petrohi/color_terminal/hardware/ascii_terminal_kicad.kicad_pcb

## KiCad design hardware/ascii_terminal_kicad.kicad_pcb (2020-11-22)

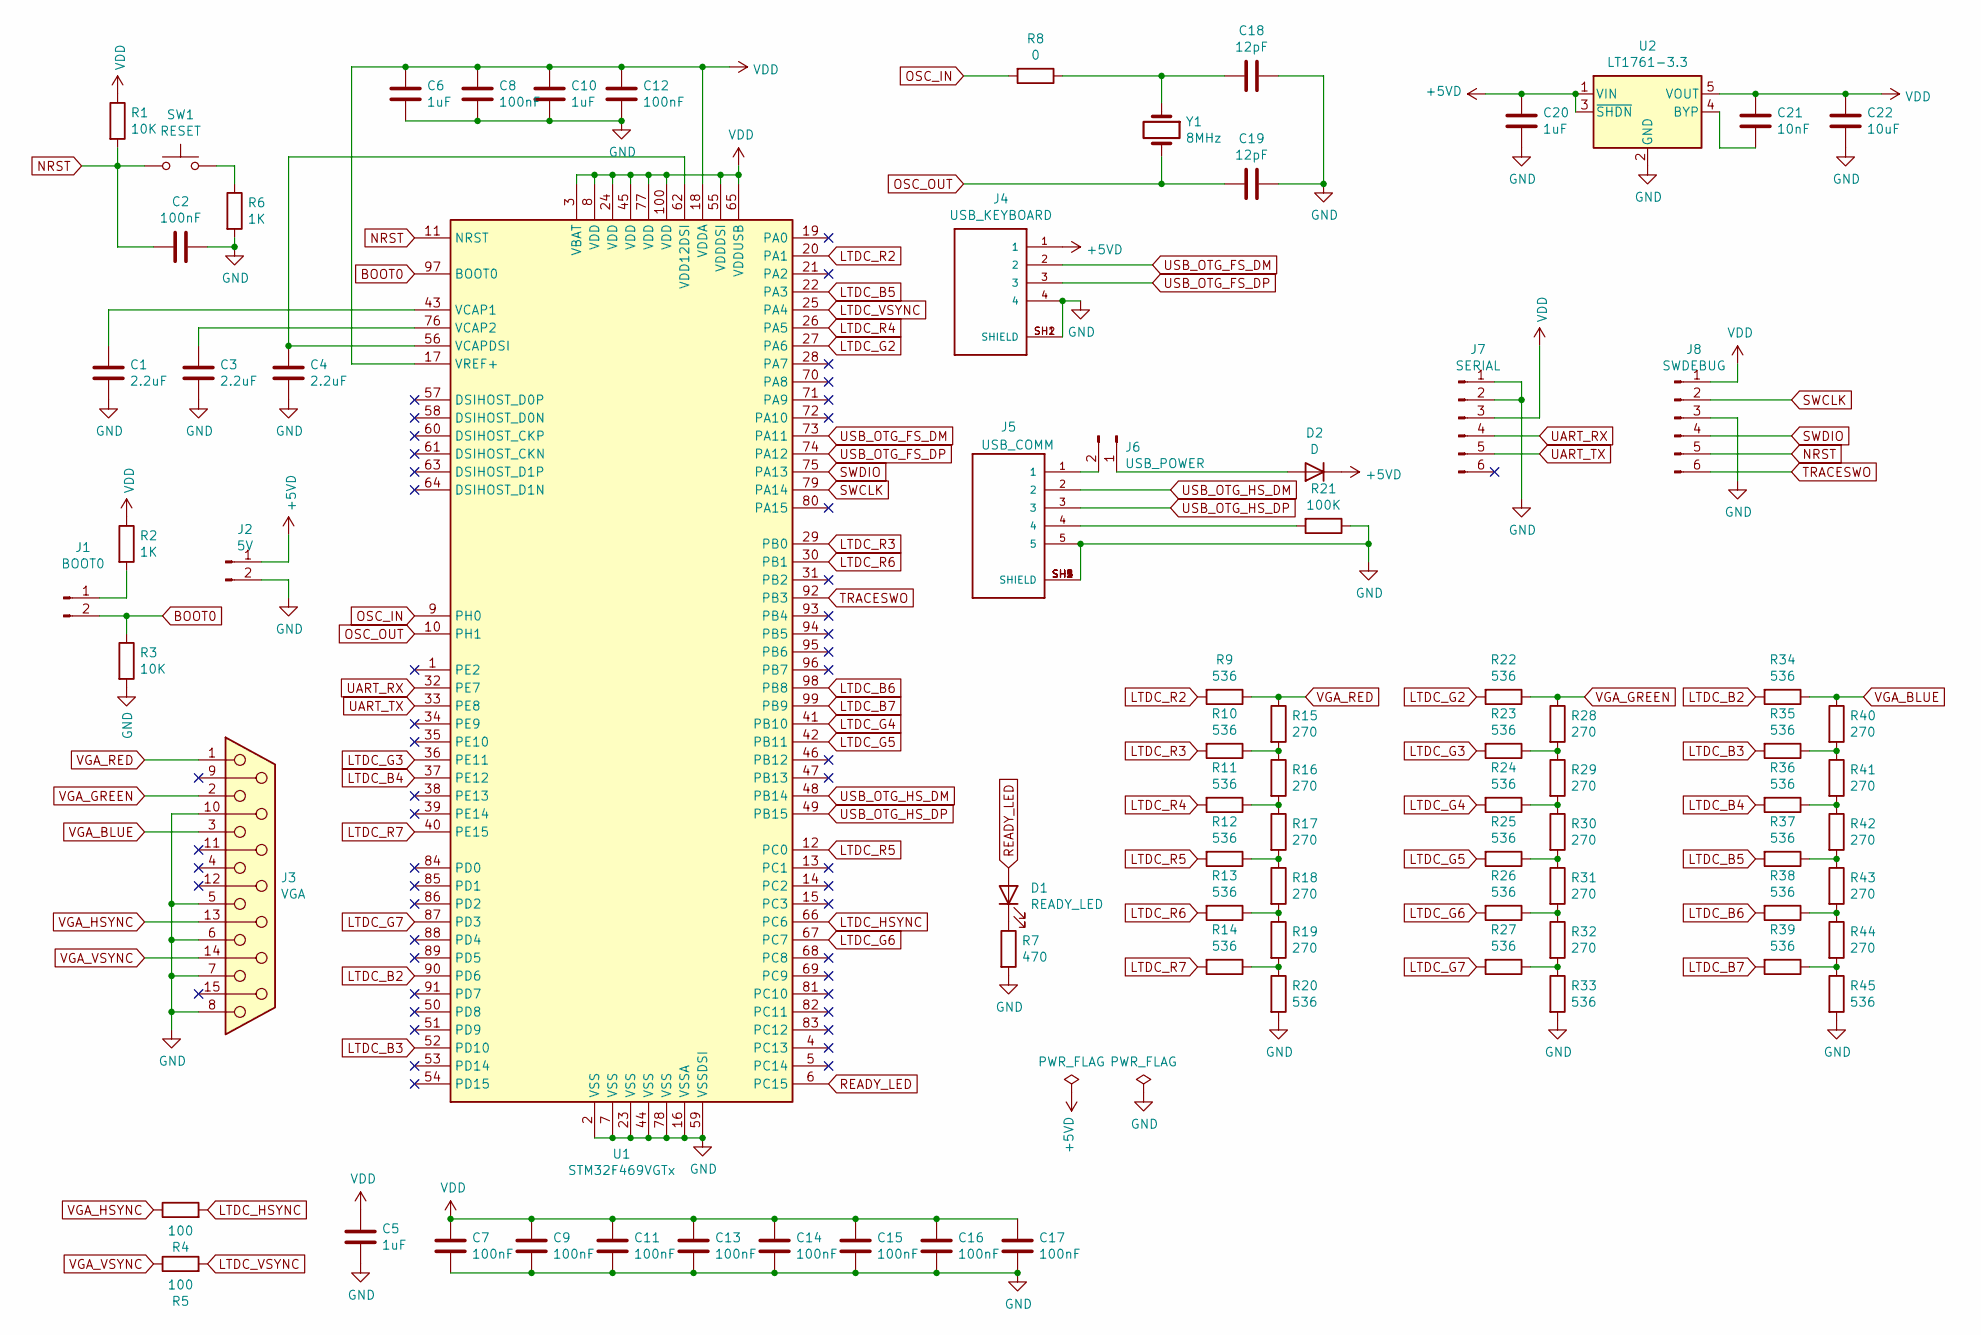
[picture p1: schematic ascii_terminal_kicad.sch]

Parts:
C1, C3, C4: 2.2uF; C_0805_2012Metric
C2, C7, C8, C9, C11, C12, C13, C14, C15, C16, C17: 100nF; C_0805_2012Metric
C5, C6, C10, C20: 1uF; C_0805_2012Metric
C18, C19: 12pF; C_0805_2012Metric
C21: 10nF; C_0805_2012Metric
C22: 10uF; C_0805_2012Metric
D1: READY_LED; LED_0805_2012Metric
D2: D; D_1206_3216Metric
J1: BOOT0; PinHeader_1x02_P2.54mm_Vertical
J2: 5V; PinHeader_1x02_P2.54mm_Vertical
J3: VGA; AMPHENOL_L77HDE15SD1CH4F
J4: USB_KEYBOARD; CUI_UJ2-AH-4-TH
J5: USB_COMM; CUI_UJ2-MIBH2-4-SMT
J6: USB_POWER; PinHeader_1x02_P2.54mm_Vertical
J7: SERIAL; PinHeader_1x06_P2.54mm_Vertical
J8: SWDEBUG; PinHeader_1x06_P2.54mm_Vertical
R1, R3: 10K; R_0805_2012Metric
R2, R6: 1K; R_0805_2012Metric
R4, R5: 100; R_0805_2012Metric
R7: 470; R_0805_2012Metric
R8: 0; R_0805_2012Metric
R9, R10, R11, R12, R13, R14, R20, R22, R23, R24, R25, R26, R27, R33, R34, R35, R36, R37, R38, R39, R45: 536; R_0805_2012Metric
R15, R16, R17, R18, R19, R28, R29, R30, R31, R32, R40, R41, R42, R43, R44: 270; R_0805_2012Metric
R21: 100K; R_0805_2012Metric
SW1: RESET; SW_SPST_FSMSM
U1: STM32F469VGTx; LQFP-100_14x14mm_P0.5mm
U2: LT1761-3.3; TSOT-23-5
Y1: 8MHz; Crystal_SMD_5032-2Pin_5.0x3.2mm

Connections:
+5VD: C20.1, D2.1 (K), J2.1, J4.1, U2.1 (VIN), U2.3 (~SHDN)
BOOT0: J1.2, R3.1, U1.97 (BOOT0)
GND: C1.2, C2.1, C3.2, C4.2, C5.2, C6.2, C7.2, C8.2, C9.2, C10.2, C11.2, C12.2, C13.2, C14.2, C15.2, C16.2, C17.2, C18.1, C19.1, C20.2, C22.2, J2.2, J3.5, J3.6, J3.7, J3.8, J3.10, J4.4, J4.SH1 (SHIELD), J4.SH2 (SHIELD), J5.5, J5.SH1 (SHIELD), J5.SH2 (SHIELD), J5.SH3 (SHIELD), J5.SH4 (SHIELD), J5.SH5 (SHIELD), J7.1, J7.2, J8.3, R3.2, R6.2, R7.2, R20.2, R21.1, R33.2, R45.2, U1.2 (VSS), U1.7 (VSS), U1.16 (VSSA), U1.23 (VSS), U1.44 (VSS), U1.59 (VSSDSI), U1.78 (VSS), U2.2 (GND)
LTDC_B2: R34.2, U1.90 (PD6)
LTDC_B3: R35.2, U1.52 (PD10)
LTDC_B4: R36.2, U1.37 (PE12)
LTDC_B5: R37.2, U1.22 (PA3)
LTDC_B6: R38.2, U1.98 (PB8)
LTDC_B7: R39.2, U1.99 (PB9)
LTDC_G2: R22.2, U1.27 (PA6)
LTDC_G3: R23.2, U1.36 (PE11)
LTDC_G4: R24.2, U1.41 (PB10)
LTDC_G5: R25.2, U1.42 (PB11)
LTDC_G6: R26.2, U1.67 (PC7)
LTDC_G7: R27.2, U1.87 (PD3)
LTDC_HSYNC: R4.2, U1.66 (PC6)
LTDC_R2: R9.2, U1.20 (PA1)
LTDC_R3: R10.2, U1.29 (PB0)
LTDC_R4: R11.2, U1.26 (PA5)
LTDC_R5: R12.2, U1.12 (PC0)
LTDC_R6: R13.2, U1.30 (PB1)
LTDC_R7: R14.2, U1.40 (PE15)
LTDC_VSYNC: R5.2, U1.25 (PA4)
NRST: C2.2, J8.5, R1.2, SW1.1, U1.11 (NRST)
unnamed: C1.1, U1.43 (VCAP1)
unnamed: C3.1, U1.76 (VCAP2)
unnamed: C4.1, U1.56 (VCAPDSI), U1.62 (VDD12DSI)
unnamed: C18.2, R8.1, Y1.1
unnamed: C21.2, U2.4 (BYP)
unnamed: D1.1 (K), R7.1
unnamed: D2.2 (A), J6.1
unnamed: J1.1, R2.2
unnamed: J5.1, J6.2
unnamed: J5.4, R21.2
unnamed: R6.1, SW1.2
unnamed: R10.1, R15.2, R16.1
unnamed: R11.1, R16.2, R17.1
unnamed: R12.1, R17.2, R18.1
unnamed: R13.1, R18.2, R19.1
unnamed: R14.1, R19.2, R20.1
unnamed: R23.1, R28.2, R29.1
unnamed: R24.1, R29.2, R30.1
unnamed: R25.1, R30.2, R31.1
unnamed: R26.1, R31.2, R32.1
unnamed: R27.1, R32.2, R33.1
unnamed: R35.1, R40.2, R41.1
unnamed: R36.1, R41.2, R42.1
unnamed: R37.1, R42.2, R43.1
unnamed: R38.1, R43.2, R44.1
unnamed: R39.1, R44.2, R45.1
OSC_IN: R8.2, U1.9 (PH0)
OSC_OUT: C19.2, U1.10 (PH1), Y1.2
READY_LED: D1.2 (A), U1.6 (PC15)
SWCLK: J8.2, U1.79 (PA14)
SWDIO: J8.4, U1.75 (PA13)
TRACESWO: J8.6, U1.92 (PB3)
UART_RX: J7.4, U1.32 (PE7)
UART_TX: J7.5, U1.33 (PE8)
USB_OTG_FS_DM: J4.2, U1.73 (PA11)
USB_OTG_FS_DP: J4.3, U1.74 (PA12)
USB_OTG_HS_DM: J5.2, U1.48 (PB14)
USB_OTG_HS_DP: J5.3, U1.49 (PB15)
VDD: C5.1, C6.1, C7.1, C8.1, C9.1, C10.1, C11.1, C12.1, C13.1, C14.1, C15.1, C16.1, C17.1, C21.1, C22.1, J7.3, J8.1, R1.1, R2.1, U1.3 (VBAT), U1.8 (VDD), U1.17 (VREF+), U1.18 (VDDA), U1.24 (VDD), U1.45 (VDD), U1.55 (VDDDSI), U1.65 (VDDUSB), U1.77 (VDD), U1.100 (VDD), U2.5 (VOUT)
VGA_BLUE: J3.3, R34.1, R40.1
VGA_GREEN: J3.2, R22.1, R28.1
VGA_HSYNC: J3.13, R4.1
VGA_RED: J3.1, R9.1, R15.1
VGA_VSYNC: J3.14, R5.1

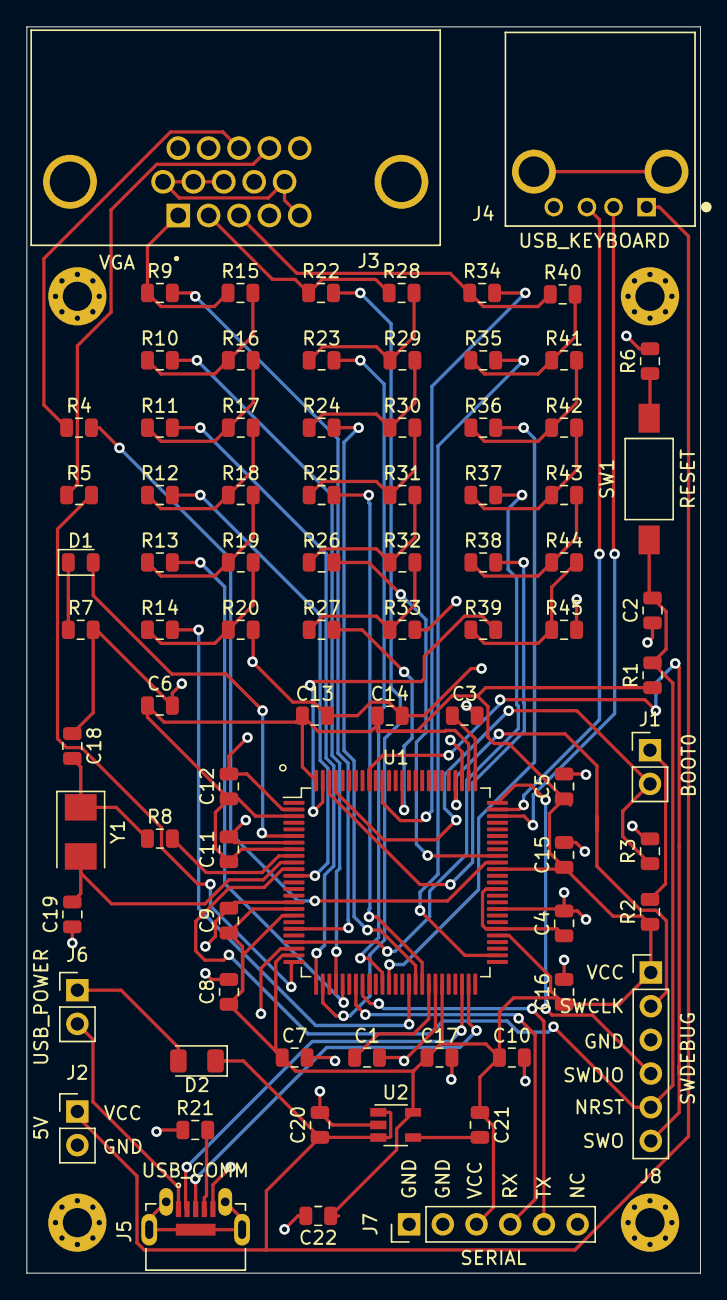
[picture p2: board ascii_terminal_kicad.kicad_pcb from above]

Board: 2 copper layers, 50.8 x 94.0 mm, 85 parts (0 on the bottom side), 68 nets.

Other parts of the board:
REF1, REF2, REF3, REF4: MountingHole_2.2mm_M2_Pad_Via
