petrohi/color_terminal/color_terminal.ioc

PC15/OSC32_OUT.GPIO_Label=READY_LED
Mcu.UserName=STM32F469VGTx
PB11.Signal=LTDC_G5
PB15.Signal=USB_OTG_HS_DP
PA12.Signal=USB_OTG_FS_DP
PC7.Signal=LTDC_G6
PH1/OSC_OUT.Signal=RCC_OSC_OUT
PE13.Signal=LTDC_DE
PB9.Signal=LTDC_B7
PB1.Signal=LTDC_R6
PA6.Signal=LTDC_G2
PE7.Signal=UART7_RX
PD6.Signal=LTDC_B2
PA3.Signal=LTDC_B5
PD3.Signal=LTDC_G7
PC6.Signal=LTDC_HSYNC
PC0.Signal=LTDC_R5
PD10.Signal=LTDC_B3
PE11.Signal=LTDC_G3
PA1.Signal=LTDC_R2
PB10.Signal=LTDC_G4
PB14.Signal=USB_OTG_HS_DM
PA5.Signal=LTDC_R4
PH0/OSC_IN.Signal=RCC_OSC_IN
PE14.Signal=LTDC_CLK
PE15.Signal=LTDC_R7
PE8.Signal=UART7_TX
PE12.Signal=LTDC_B4
PA4.Signal=LTDC_VSYNC
PA11.Signal=USB_OTG_FS_DM
PB8.Signal=LTDC_B6
PC15/OSC32_OUT.Signal=GPIO_Output
PB0.Signal=LTDC_R3
