petrohi/color_terminal/Core/Inc/terminal_internal.h

#pragma once

#include "terminal.h"

#define CHAR_XOFF '\x13'
#define CHAR_XON '\x11'

#define ROWS terminal->format.rows
#define COLS terminal->format.cols

void terminal_uart_init(struct terminal *terminal);

void terminal_uart_xon_off(struct terminal *terminal, enum xon_off xon_off);

void terminal_keyboard_init(struct terminal *terminal,
                            enum keyboard_layout keyboard_layout);

void terminal_keyboard_update_repeat_counter(struct terminal *terminal);

void terminal_screen_init(struct terminal *terminal);

int16_t get_terminal_screen_cursor_row(struct terminal *terminal);

int16_t get_terminal_screen_cursor_col(struct terminal *terminal);

void terminal_screen_update_cursor_counter(struct terminal *terminal);

void terminal_screen_update_blink_counter(struct terminal *terminal);

void terminal_screen_move_cursor_absolute(struct terminal *terminal,
                                          int16_t row, int16_t col);

void terminal_screen_move_cursor(struct terminal *terminal, int16_t rows,
                                 int16_t cols);

void terminal_screen_carriage_return(struct terminal *terminal);

void terminal_screen_scroll(struct terminal *terminal, enum scroll scroll,
                            size_t from_row, size_t rows);

void terminal_screen_clear_to_right(struct terminal *terminal);

void terminal_screen_clear_to_left(struct terminal *terminal);

void terminal_screen_clear_row(struct terminal *terminal);

void terminal_screen_clear_to_top(struct terminal *terminal);

void terminal_screen_clear_to_bottom(struct terminal *terminal);

void terminal_screen_clear_all(struct terminal *terminal);

void terminal_screen_index(struct terminal *terminal, int16_t rows);

void terminal_screen_reverse_index(struct terminal *terminal, int16_t rows);

void terminal_screen_put_codepoint(struct terminal *terminal,
                                   codepoint_t codepoint);

void terminal_screen_enable_cursor(struct terminal *terminal, bool enable);

void terminal_screen_save_visual_state(struct terminal *terminal);

void terminal_screen_restore_visual_state(struct terminal *terminal);

void terminal_screen_delete(struct terminal *terminal, size_t cols);

void terminal_screen_insert(struct terminal *terminal, size_t cols);

void terminal_screen_erase(struct terminal *terminal, size_t cols);

void terminal_screen_set_screen_mode(struct terminal *terminal, bool mode);

void terminal_screen_wrap_last_col(struct terminal *terminal);

void terminal_screen_cancel_wrap_last_col(struct terminal *terminal);

#ifdef TERMINAL_ALT_CELLS
void terminal_screen_use_alt_cells(struct terminal *terminal);

void terminal_screen_restore_default_cells(struct terminal *terminal);
#endif
