petrohi/color_terminal/(commit log)

2020-06-07 DMA for UART
2020-06-08 UART transmit
2020-06-08 Print current Mandelbrot window to UART
2020-06-11 Circular DMA mode for UART receive
2020-06-14 Receive from UART and draw characters
2020-06-20 Split terminal into UART, keyboard and screen modules
2020-06-21 Printf unexpected control sequence
2020-06-23 Default auto-wrap mode to reset
    [terminal_screen.c]
2020-06-23 Set UART to 38400 baud rate
2020-06-25 Insert/delete/erase characters. Absolute vertical/horizontal position.
2020-06-26 Insert/delete lines
2020-06-28 Tab stops. Printf control sequences.
2020-06-29 Fix transmit printf
2020-07-04 Back to font-problems. Handle UTF8 via receive tables.
    [main.c, screen.c, screen.h, terminal.h, terminal_uart.c]
2020-07-07 Use USART3. Flow control with XON/OFF.
2020-07-19 Circular buffering for UART transmit
2020-07-26 Yield to probe keyboard
2020-07-29 Probe keyboard when in config UI
2020-07-31 Config for flow control and inverted serial
    [main.c, terminal.c, terminal.h, terminal_config.h, terminal_config_ui.c, terminal_internal.h, terminal_uart.c]
2020-07-31 Re-use terminal keyboard driver for config UI
2020-08-02 Fix line-wrapping semantics according DEC STD-070 with wraptest
    [terminal_internal.h, terminal_screen.c, terminal_uart.c]
2020-08-02 Fix color adjustments when rendering character
    [terminal_screen.c]
2020-11-16 Port to STM32F469VGTx
2020-11-16 Fix UART NVIC settings
    [color_terminal.ioc]
2020-11-16 Fix CLUT for RGB2-7 pins reversed
    [ltdc.c]
2020-11-16 Set ready LED at the end of initialization
